jewelux/talking-swr-meter-LX1WJ/docs/Test-Breadboard Talking-SWR-Meter 02.png

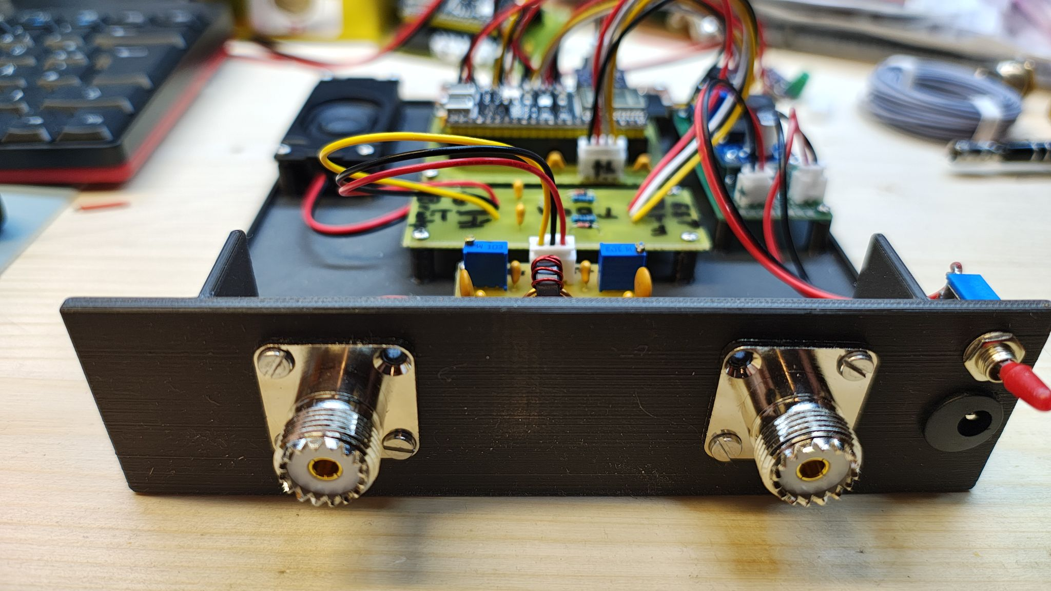
docs/Test-Breadboard Talking-SWR-Meter 02.png
