jewelux/talking-swr-meter-LX1WJ/docs/Test-Breadboard Talking-SWR-Meter 01.png

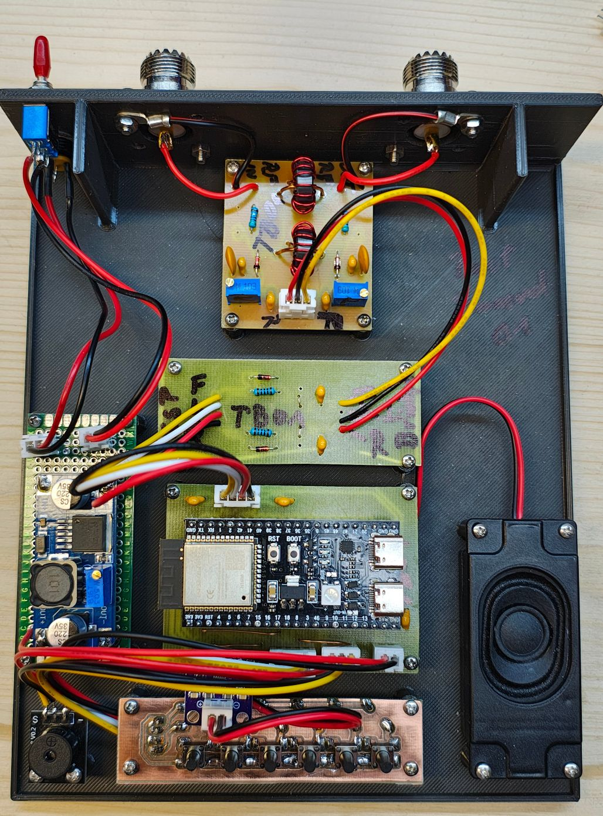
docs/Test-Breadboard Talking-SWR-Meter 01.png
