jewelux/talking-swr-meter-LX1WJ/docs/Circuit Diagramm DIY SWR Bridge.pdf

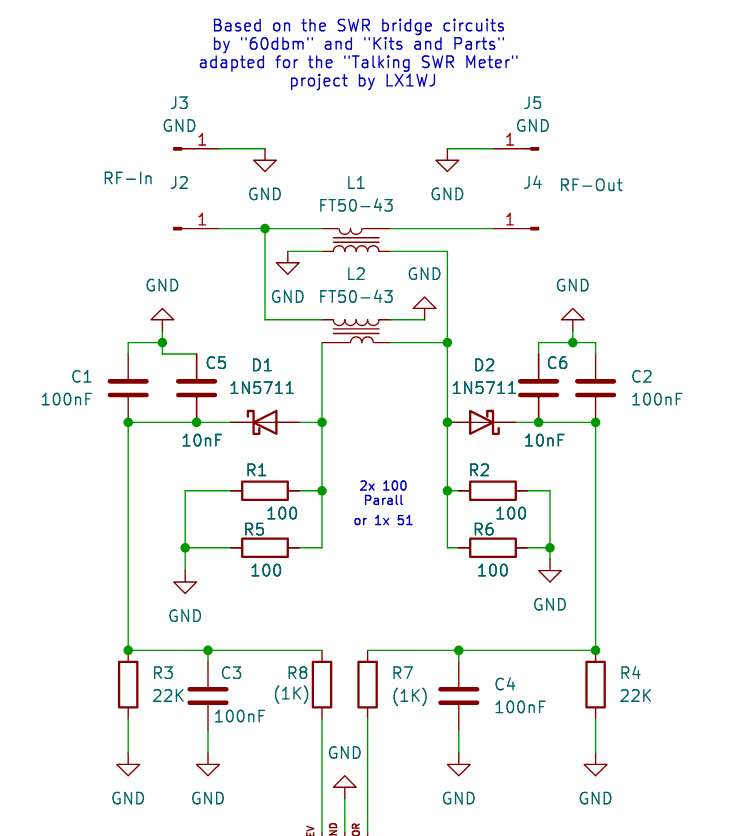
[picture p3: page 1]
