jewelux/talking-swr-meter-LX1WJ/docs/PCB-Layout- SWR-Bridge.pdf

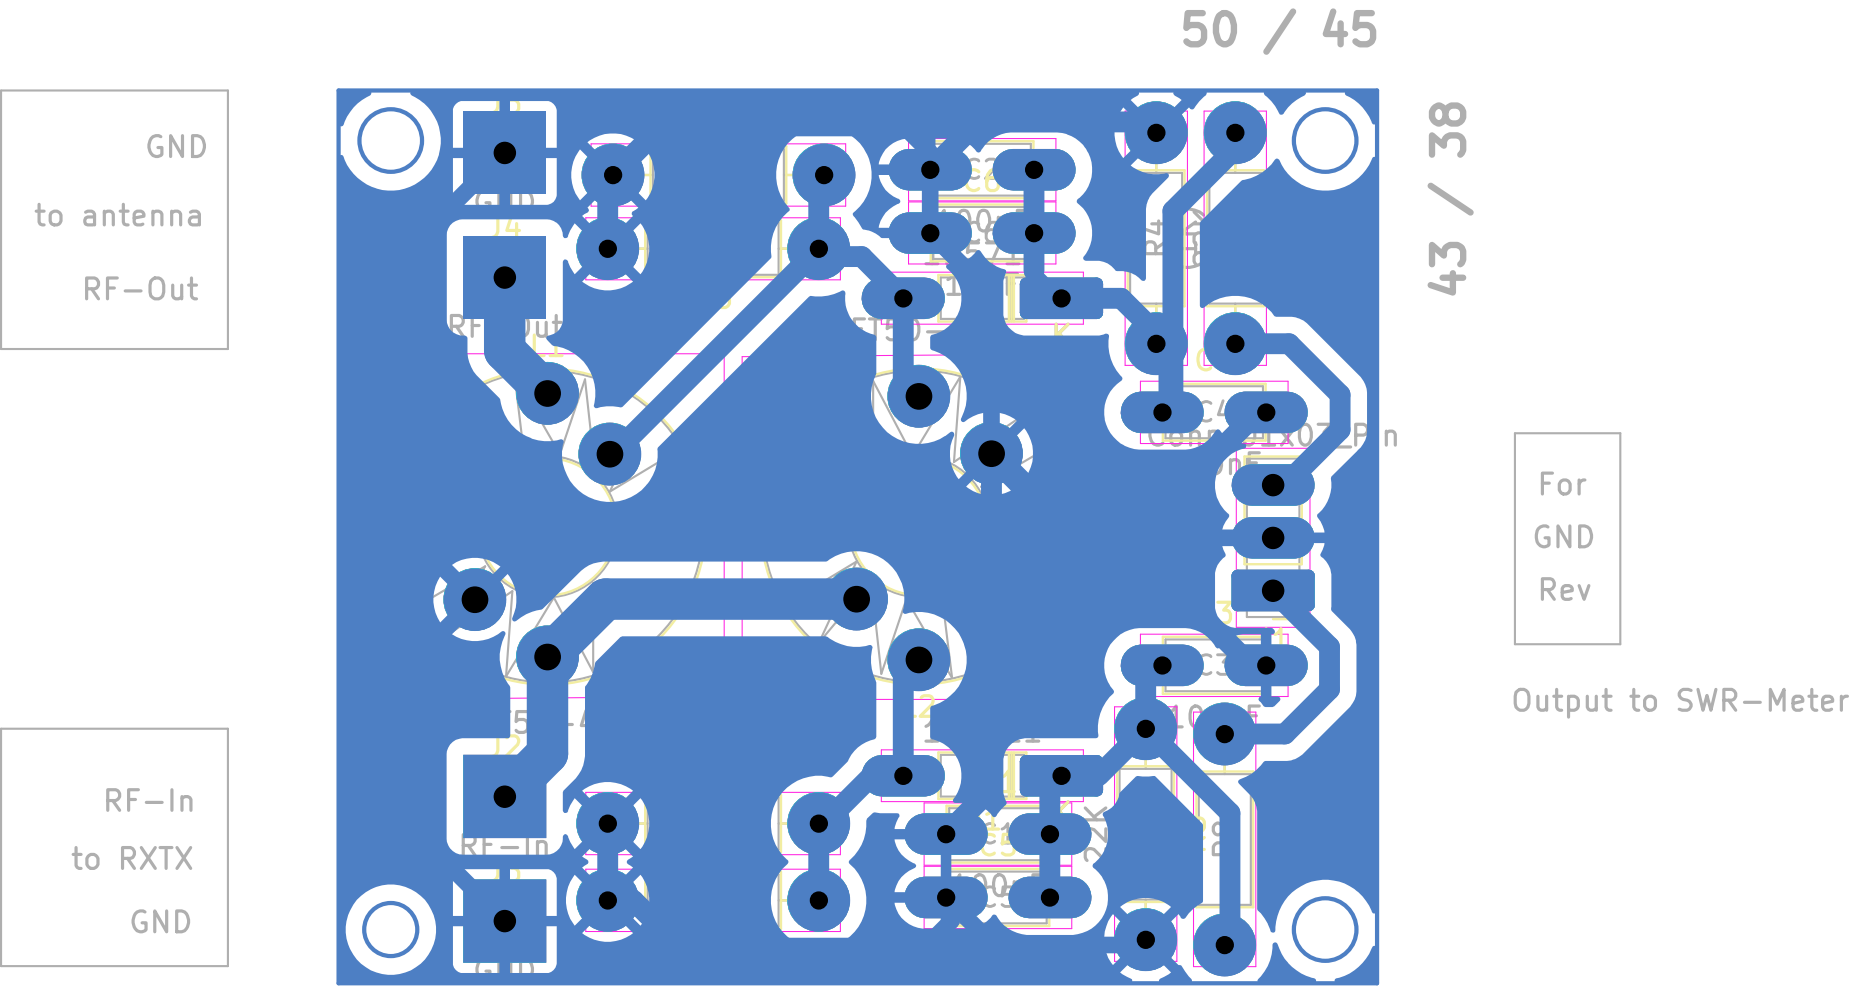
[picture p5: page 1]
