jewelux/talking-swr-meter-LX1WJ/docs/Circuit Diagramm Talking-SWR-Meter by LX1WJ.pdf

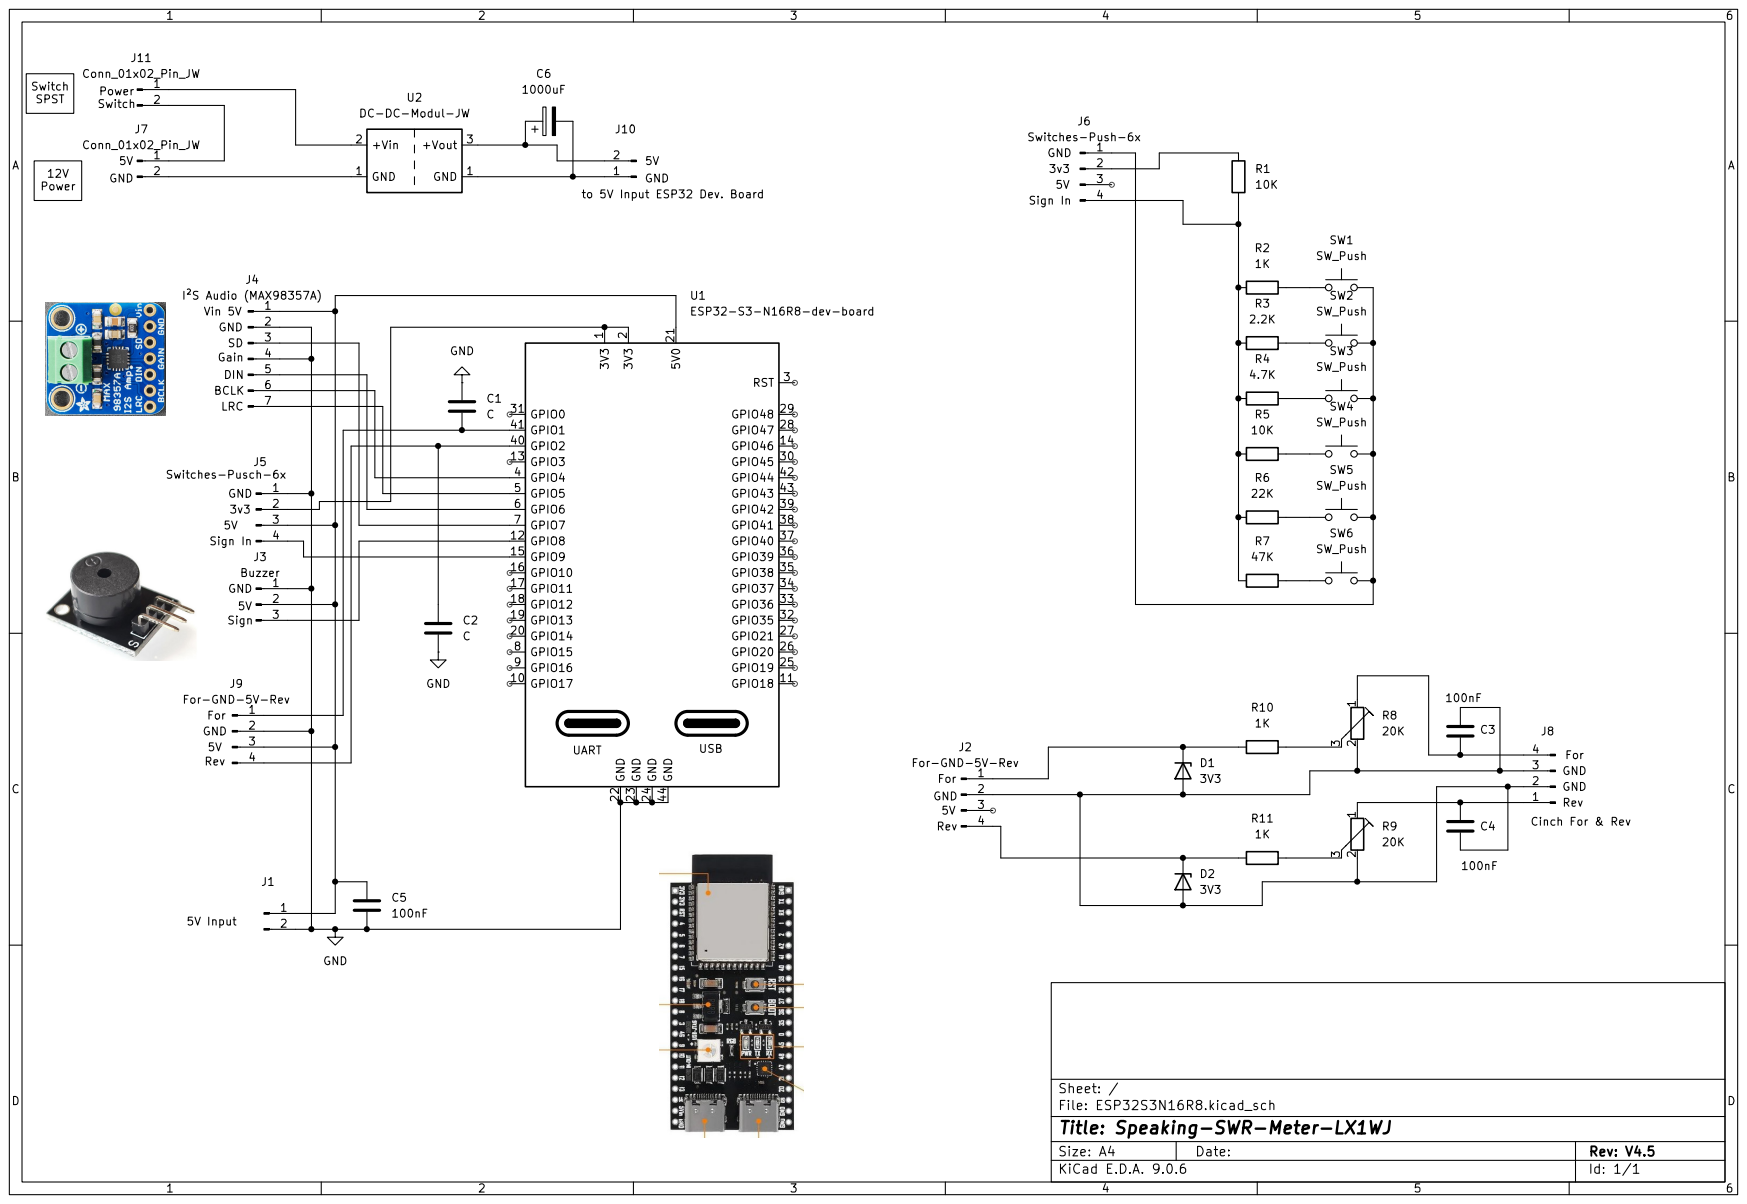
[picture p6: page 1]
