jewelux/talking-swr-meter-LX1WJ/docs/PCBs Talking-SWR-Meter by LX1WJ.pdf

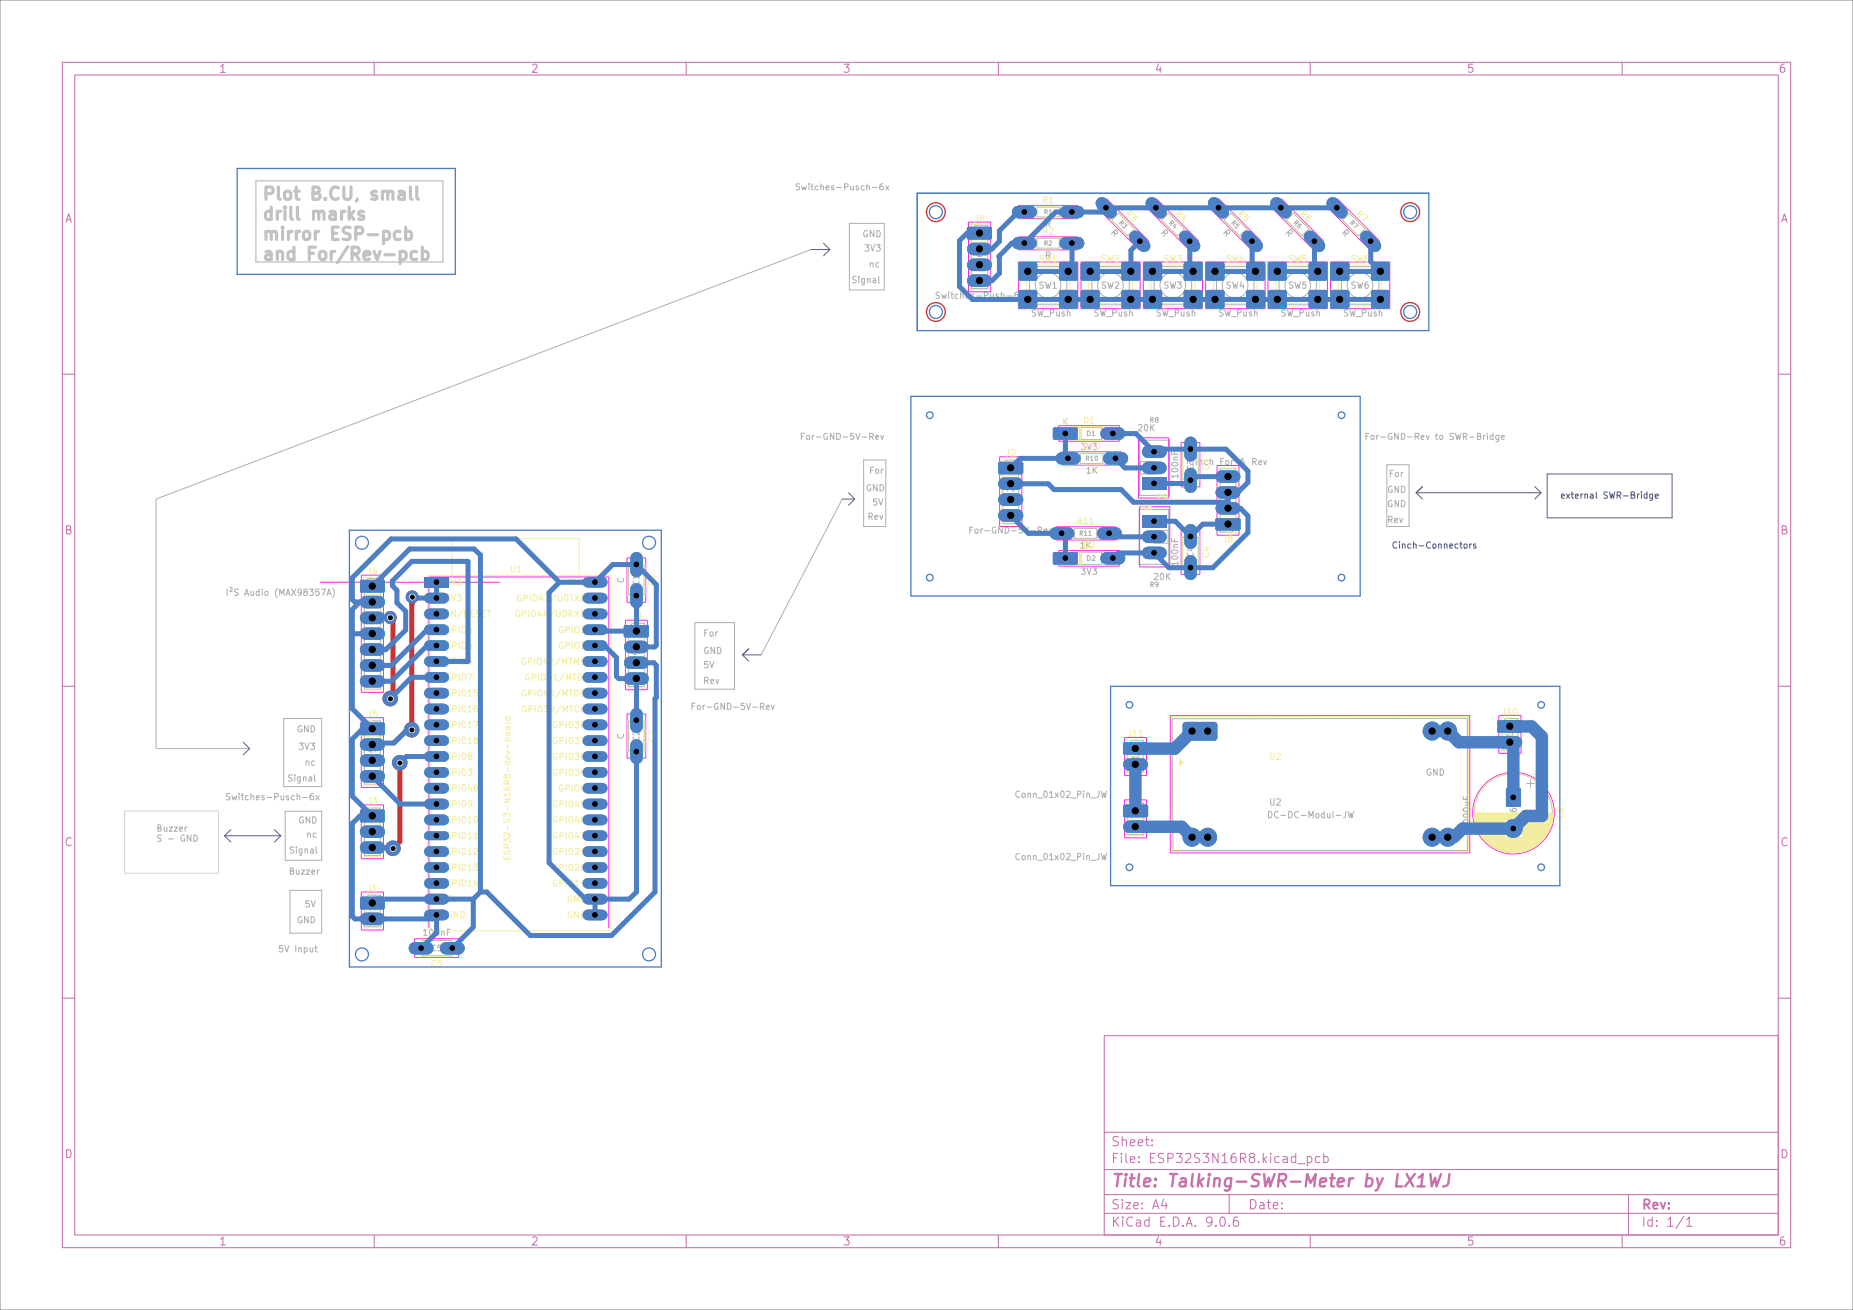
[picture p7: page 1]
