jewelux/talking-swr-meter-LX1WJ/(commit log)

2026-01-13 Create bom-V541
2026-01-13 Update and rename bom-V541 to bom-V541.txt
2026-03-22 Update Quick guide for calibration V5_5.txt
