jewelux/talking-swr-meter-LX1WJ/docs/Proto 1 Talking-SWR-Meter.jpg

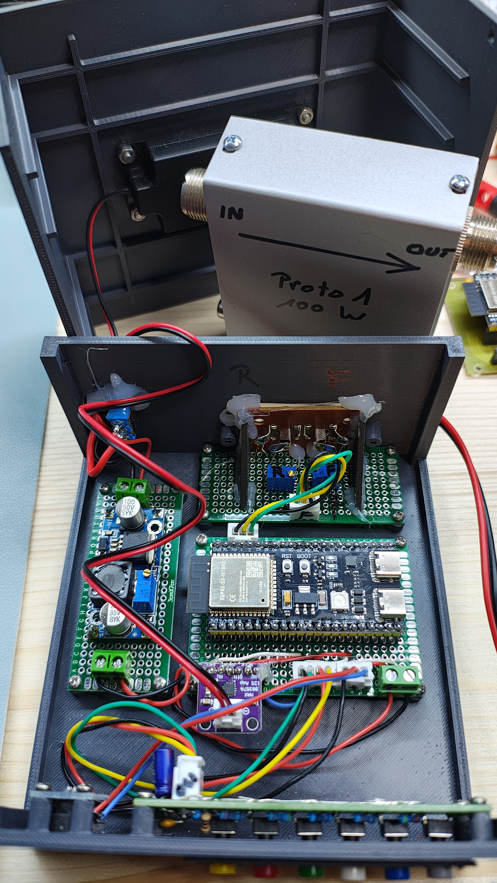
docs/Proto 1 Talking-SWR-Meter.jpg
